nugentlj8/davis-vp2-smart-station/(commit log)

2026-09-20 Davis Vantage Pro2 -> ESP32 -> Home Assistant smart weather station
    Turns a 2004 Davis Vantage Pro2 console into a fully networked weather
    station without the $235 proprietary data logger.
    - firmware/: ESP32 Arduino bridge that wakes the console, reads its 99-byte
    binary LOOP packets over 3.3V TTL serial, validates each with CRC-CCITT,
    decodes the little-endian fields, and publishes via MQTT auto-discovery.
    Rejects the console's "no data" sentinels (0xFF/0xFFFF/32767) and self-heals
    via UART re-init, stale-data reboot, and a weekly scheduled reboot.
    - homeassistant/: template sensors (wind chill, dew point, apparent
    temperature, cardinal wind, moon phase, barometer-trend icon), th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
    [dashboard.yaml, davis_vp2_bridge.ino]
2026-09-20 docs: add expansion connector pinout diagram to hardware setup
    Embeds the VP2 2x10 expansion header pinout above the wiring table, so the
    three pins the bridge uses (6 TXD0, 5 RXD0, 16 GND) can be counted against a
    picture instead of a known-good photo found elsewhere. Notes that the diagram
    is drawn from the back of the console, since the rows mirror from the front.
    EXIF metadata stripped from the image (APP1 segment removed).
2026-09-20 docs: credit third-party sources for the pinout and forecast tables
    The expansion-port pinout diagram is DeKay's, from the 2011 Mad Scientist Labs
    post that first documented the port publicly. Credits it under the image and
    adds an Acknowledgements section covering that post, the CumulusMX forecast_rule
    lookup table, and the Davis serial reference manual.
    Notes that the MIT grant covers this project's own code and docs, not the
    third-party material reproduced for reference.
    Also drops a stray heredoc "EOF" marker left at the end of README.md.
2026-09-20 Make the project reproducible by someone other than the author
    The repo documented the build but not what it depends on, and several configs
    pointed at entity IDs that only exist on the original install. Fixes both.
    Blockers:
    - Normalize sensor.office_davis_vantage_pro2_* -> sensor.davis_vantage_pro2_*
    (23 refs across dashboard, template sensors, and the cleanup SQL). The prefix
    came from renaming the MQTT device locally, so the later-added entities picked
    it up while the originals kept theirs. On a fresh install those references
    resolved to nothing and failed silently. Both docs now warn against renaming.
    - Document the four HACS cards dashboard.yaml needs (apexcharts-card,
    stack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
    [dashboard.yaml, davis_vp2_bridge.ino]
2026-09-20 Add photos and screenshots, and document the deployment setup
    The repo described the build in prose with nothing to look at. Adds the
    hardware photo and both dashboard views near the top, where a reader sees
    them first.
    All three images were re-encoded from raw pixels to drop metadata. The
    hardware photo came off a phone carrying GPS coordinates accurate to ~7 m,
    plus device model and capture time; none of that is in the committed file.
    It is also resized from 5712x4284 (3.7 MB) to 2000x1500 (0.35 MB).
    Also documents the two pieces of the deployment that were listed under
    "Tech & skills" but explained nowhere:
    - Home Assistant in Docker, why it's the practical choice, what changes if
    you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
2026-09-20 Correct the board model and the hardware photo caption
    The docs described an ESP32-S3 in five places; the build actually uses a
    classic ESP-WROOM-32 (ELEGOO EL-SM-012, USB-C, 520 KB SRAM / 4 MB flash).
    Names the specific board while keeping the instructions board-agnostic, since
    only GPIO 17/18 and a spare hardware UART are required, and covers both board
    choices in the Arduino IDE step.
    Fixes the photo caption: the three wires go into the expansion port on the
    back of the console, not the top. The ESP32 is only resting there.
2026-09-20 docs: explain what actually changes the generated entity IDs
    Verified against a live install: the sensor.office_davis_vantage_pro2_* IDs
    come from the device being assigned to an area, not from renaming it. The
    entity registry shows entities created before the area assignment keeping
    unprefixed IDs and everything created after picking up the area name, on the
    same device with no user-set name.
    That matters because assigning a device to an area is a normal thing to do,
    and it only affects entities created afterwards -- so a device that gains an
    area partway through ends up with a mix of both forms, which is hard to
    diagnose from the symptom (a few sensors silently unavailable).
    Documents bo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
2026-09-20 Add a Why section, a runnable example workbook, and Hours label parsing
    Why: the README opened with what the project is but never said what prompted
    it -- twenty years of copying highs and lows off the LCD into a spreadsheet by
    hand, a $235 logger as the only sanctioned alternative, and no single writeup
    of the console-to-Home-Assistant path anywhere.
    Example workbook: data/Weather_History_Log.example.xlsx is synthetic data
    covering all four tabs and every metric column, so the importer can be run and
    verified before anyone builds a real spreadsheet. Parses to 25 statistics /
    177 points. The pattern in .gitignore still excludes a real workbook.
    Importer fix: period_start() raised "bad labe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
    [Weather_History_Log.example.xlsx]
2026-11-01 Add muse-proxy: allow-list gateway for AI assistant access to Home Assistant
    Read-only station sensors, history, imported archive (/archive) and NWS
    forecast, plus light/fan control. Token stays server-side; config is a
    sanitized example.
